f4goh/vocalSwrMeter/images/tendance.png

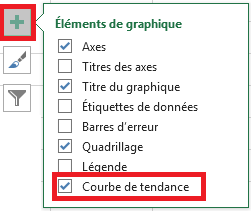
images/tendance.png
