f4goh/vocalSwrMeter/measures/measures.xlsx

direct |  |  | reverse
dbm cmu | dbm mesure | num | dbm mesure | num | différence
10 | 10.03 | 563 | -6.88 | 390 | 16.91 |  |  |  | num | dbm reverse
0 | -0.13 | 460 | -17.14 | 285 | 17.01 |  |  |  | 563 | 10
-10 | -10.3 | 355 | -25.94 | 195 | 15.64 |  |  |  | 460 | 0
-20 | -20.37 | 252 | -28.68 | 167 | 8.31 |  |  |  | 355 | -10
-30 | -28.09 | 173 | -29.07 | 163 | 0.98 |  |  |  | 252 | -20
reverse |  |  | direct
dbm cmu | dbm mesure | num | dbm mesure | num |  |  |  |  | num | dbm direct
10 | -21.54 | 240 | 8.96 | 552 | 30.5 |  |  |  | 552 | 10
0 | -24.67 | 208 | -1.3 | 447 | 23.37 |  |  |  | 447 | 0
-10 | -29.07 | 163 | -11.57 | 342 | 17.5 |  |  |  | 342 | -10
-20 | -29.07 | 163 | -21.64 | 239 | 7.43 |  |  |  | 239 | -20
-30 | -28.97 | 164 | -27.5 | 179 | 1.47
 |  |  |  |  |  | Générateur HF (dBm) | Valeur CAN fwd | Valeur CAN fwd
 |  |  |  |  |  | 10 | 552 | 563
 |  |  |  |  |  | 0 | 447 | 460
 |  |  |  |  |  | -10 | 342 | 355
 |  |  |  |  |  | -20 | 239 | 252
